isaxito/SolarBatteryCharger/README.md

STM32F103T8 based Battery charger using a 10W solar panel. This is part of my Engineering degree final project.
