isaxito/SolarBatteryCharger/CargadorDeBaterias_rev2/CargadorDeBaterias_rev2.kicad_pcb

## KiCad design CargadorDeBaterias_rev2/CargadorDeBaterias_rev2.kicad_pcb (2025-11-28)

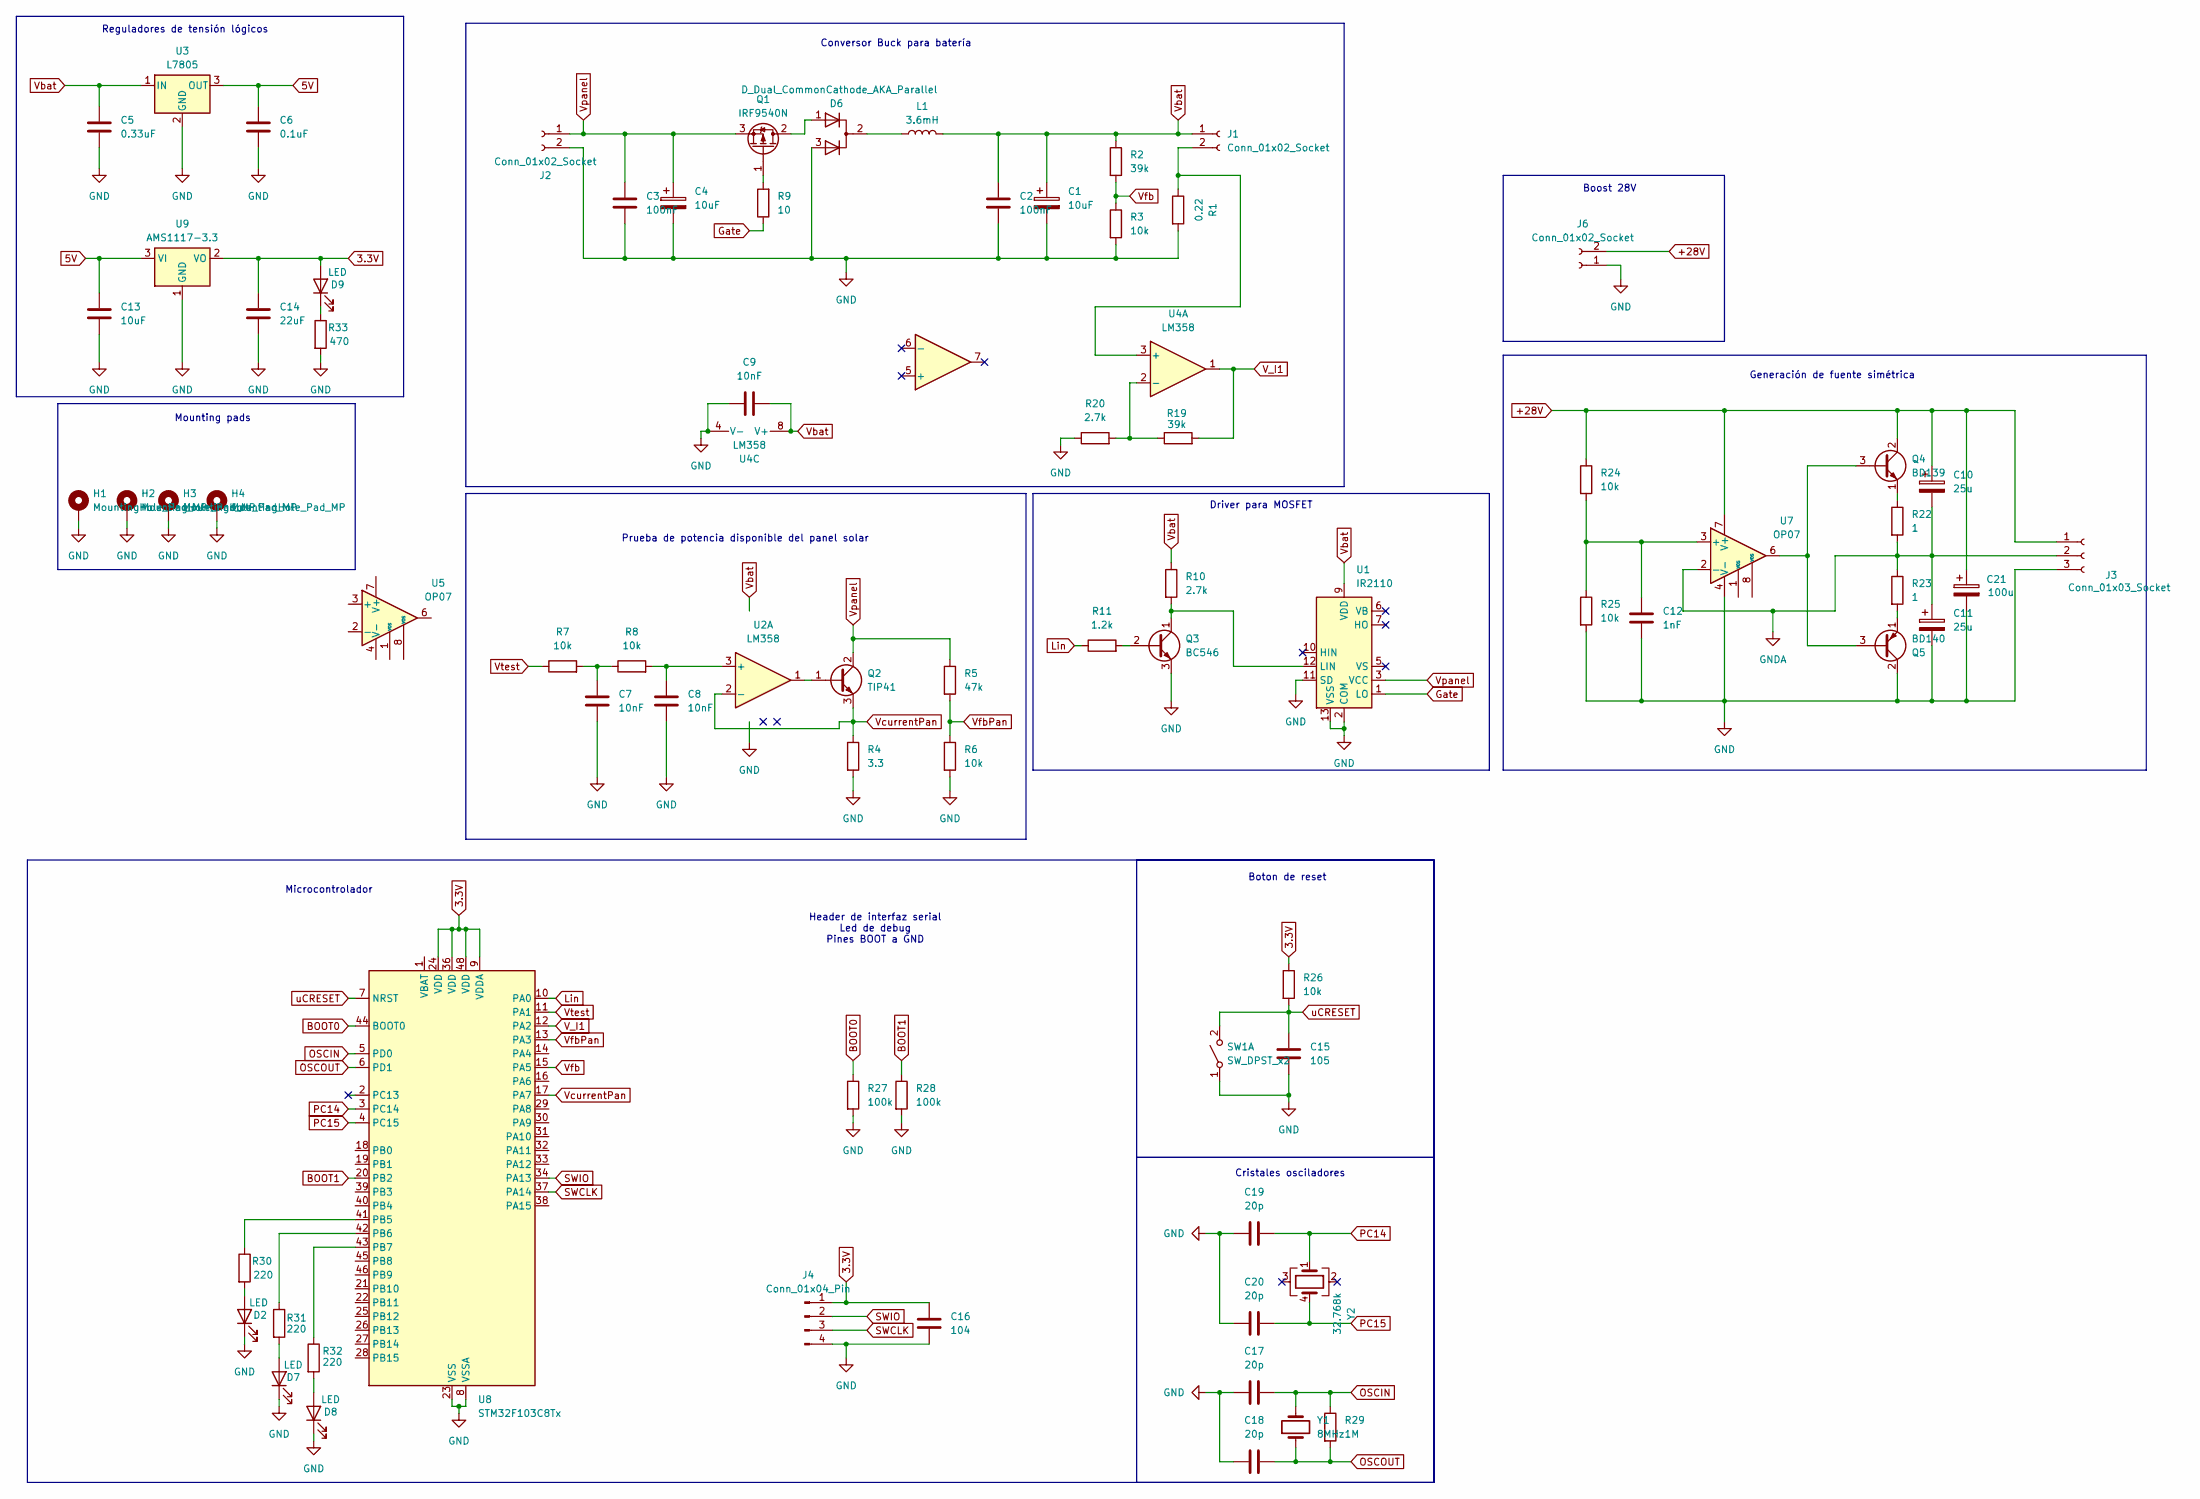
[picture p1: schematic CargadorDeBaterias_rev2.kicad_sch]

Parts:
C1, C4: 10uF; CP_Radial_D5.0mm_P2.50mm
C2, C3: 100nF; C_Disc_D5.0mm_W2.5mm_P5.00mm
C5: 0.33uF; C_Disc_D5.0mm_W2.5mm_P5.00mm
C6: 0.1uF; C_Disc_D5.0mm_W2.5mm_P5.00mm
C7, C8, C9: 10nF; C_Disc_D5.0mm_W2.5mm_P5.00mm
C10, C11: 25u; CP_Radial_D5.0mm_P2.50mm
C12: 1nF; C_Disc_D5.0mm_W2.5mm_P5.00mm
C13: 10uF; C_Disc_D5.0mm_W2.5mm_P5.00mm
C14: 22uF; C_Disc_D5.0mm_W2.5mm_P5.00mm
C15: 105; C_0603_1608Metric_Pad1.08x0.95mm_HandSolder
C16: 104; C_0603_1608Metric_Pad1.08x0.95mm_HandSolder
C17, C18, C19, C20: 20p; C_0603_1608Metric_Pad1.08x0.95mm_HandSolder
C21: 100u; CP_Radial_D6.3mm_P2.50mm
D2, D7, D8, D9: LED; LED_D5.0mm_FlatTop
D6: D_Dual_CommonCathode_AKA_Parallel; TO-220-3_Vertical
H1, H2, H3, H4: MountingHole_Pad_MP; MountingHole_3mm_Pad
J1, J2, J6: Conn_01x02_Socket; TerminalBlock_bornier-2_P5.08mm
J3: Conn_01x03_Socket; TerminalBlock_bornier-3_P5.08mm
J4: Conn_01x04_Pin; PinHeader_1x04_P2.54mm_Horizontal
L1: 3.6mH; L_Radial_D7.5mm_P3.50mm_Fastron_07P
Q1: IRF9540N; TO-220-3_Vertical
Q2: TIP41; TO-220-3_Vertical
Q3: BC546; TO-92_Inline_Wide
Q4: BD139; TO-126-3_Vertical
Q5: BD140; TO-126-3_Vertical
R1: 0.22; R_Axial_DIN0207_L6.3mm_D2.5mm_P10.16mm_Horizontal
R2, R19: 39k; R_Axial_DIN0207_L6.3mm_D2.5mm_P10.16mm_Horizontal
R3, R6, R7, R8, R24, R25, R26: 10k; R_Axial_DIN0207_L6.3mm_D2.5mm_P10.16mm_Horizontal
R4: 3.3; R_Axial_DIN0207_L6.3mm_D2.5mm_P10.16mm_Horizontal
R5: 47k; R_Axial_DIN0207_L6.3mm_D2.5mm_P10.16mm_Horizontal
R9: 10; R_Axial_DIN0207_L6.3mm_D2.5mm_P10.16mm_Horizontal
R10, R20: 2.7k; R_Axial_DIN0207_L6.3mm_D2.5mm_P10.16mm_Horizontal
R11: 1.2k; R_Axial_DIN0207_L6.3mm_D2.5mm_P10.16mm_Horizontal
R22, R23: 1; R_Axial_DIN0207_L6.3mm_D2.5mm_P10.16mm_Horizontal
R27, R28: 100k; R_Axial_DIN0207_L6.3mm_D2.5mm_P10.16mm_Horizontal
R29: 1M; R_Axial_DIN0207_L6.3mm_D2.5mm_P10.16mm_Horizontal
R30, R31, R32: 220; R_Axial_DIN0207_L6.3mm_D2.5mm_P10.16mm_Horizontal
R33: 470; R_Axial_DIN0207_L6.3mm_D2.5mm_P10.16mm_Horizontal
SW1: SW_DPST_x2; SW_SPST_EVQPE1
U1: IR2110; DIP-14_W7.62mm
U2, U4: LM358; DIP-8_W7.62mm
U3: L7805; TO-220-3_Vertical
U5, U7: OP07; DIP-8_W7.62mm
U8: STM32F103C8Tx; LQFP-48_7x7mm_P0.5mm
U9: AMS1117-3.3; SOT-223-3_TabPin2
Y1: 8MHz; Resonator-2Pin_W8.0mm_H3.5mm
Y2: 32.768k; OSCL550P800X320X254-4N

Connections:
3.3V: C14.1, C16.1, D9.2 (A), J4.1, R26.1, U8.9 (VDDA), U8.24 (VDD), U8.36 (VDD), U8.48 (VDD), U9.2 (VO)
5V: C6.1, C13.1, U3.3 (OUT), U9.3 (VI)
+28V: C10.1, C21.1, J3.1, J6.2, Q4.2 (C), R24.1, U7.7 (V+)
BOOT0: R27.1, U8.44 (BOOT0)
BOOT1: R28.1, U8.20 (PB2)
GND: C1.2, C2.2, C3.2, C4.2, C5.2, C6.2, C7.2, C8.2, C9.1, C11.2, C12.2, C13.2, C14.2, C15.2, C16.2, C17.1, C18.1, C19.1, C20.1, C21.2, D2.1 (K), D6.3 (A), D7.1 (K), D8.1 (K), H1.MP, H2.MP, H3.MP, H4.MP, J2.2, J3.3, J4.4, J6.1, Q3.3 (E), Q5.2 (C), R1.2, R3.2, R4.2, R6.2, R20.1, R25.2, R27.2, R28.2, R33.2, SW1.1 (A), U1.2 (COM), U1.11 (SD), U1.13 (VSS), U3.2 (GND), U4.4 (V-), U5.4 (V-), U7.4 (V-), U8.8 (VSSA), U8.23 (VSS), U8.35 (VSS), U8.47 (VSS), U9.1 (GND)
GNDA: C10.2, C11.1, J3.2, R22.2, R23.1, U7.2 (-)
Gate: R9.1, U1.1 (LO)
Lin: R11.1, U8.10 (PA0)
unnamed: C7.1, R7.2, R8.1
unnamed: D2.2 (A), R30.2
unnamed: D6.2 (K), L1.1
unnamed: D7.2 (A), R31.2
unnamed: D8.2 (A), R32.2
unnamed: D9.1 (K), R33.1
unnamed: J1.2, R1.1, U4.3 (+)
unnamed: D6.1 (A), Q1.2 (D)
unnamed: Q1.1 (G), R9.2
unnamed: Q2.1 (B), U2.1, U5.6
unnamed: Q3.2 (B), R11.2
unnamed: Q3.1 (C), R10.2, U1.12 (LIN)
unnamed: Q4.3 (B), Q5.3 (B), U7.6
unnamed: Q4.1 (E), R22.1
unnamed: Q5.1 (E), R23.2
unnamed: R19.1, R20.2, U4.2 (-)
unnamed: C12.1, R24.2, R25.1, U7.3 (+)
unnamed: R30.1, U8.41 (PB5)
unnamed: R31.1, U8.42 (PB6)
unnamed: R32.1, U8.43 (PB7)
OSCIN: C17.2, R29.1, U8.5 (PD0), Y1.2
OSCOUT: C18.2, R29.2, U8.6 (PD1), Y1.1
PC14: C19.2, U8.3 (PC14), Y2.1
PC15: C20.2, U8.4 (PC15), Y2.4
SWCLK: J4.3, U8.37 (PA14)
SWIO: J4.2, U8.34 (PA13)
V_I1: R19.2, U4.1, U8.12 (PA2)
Vbat: C1.1, C2.1, C5.1, C9.2, J1.1, L1.2, R2.1, R10.1, U1.9 (VDD), U3.1 (IN), U4.8 (V+), U5.7 (V+)
VcurrentPan: Q2.3 (E), R4.1, U2.2 (-), U5.2 (-), U8.17 (PA7)
Vfb: R2.2, R3.1, U8.15 (PA5)
VfbPan: R5.2, R6.1, U8.13 (PA3)
Vpanel: C3.1, C4.1, J2.1, Q1.3 (S), Q2.2 (C), R5.1, U1.3 (VCC)
Vtest: R7.1, U8.11 (PA1)
uCRESET: C15.1, R26.2, SW1.2 (B), U8.7 (NRST)

Notes on the sheet:
Microcontrolador
Header de interfaz serial Led de debug Pines BOOT a GND
Boton de reset
Cristales osciladores
Conversor Buck para batería
Mounting pads
Driver para MOSFET
Boost 28V
Generación de fuente simétrica
Prueba de potencia disponible del panel solar
Reguladores de tensión lógicos

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
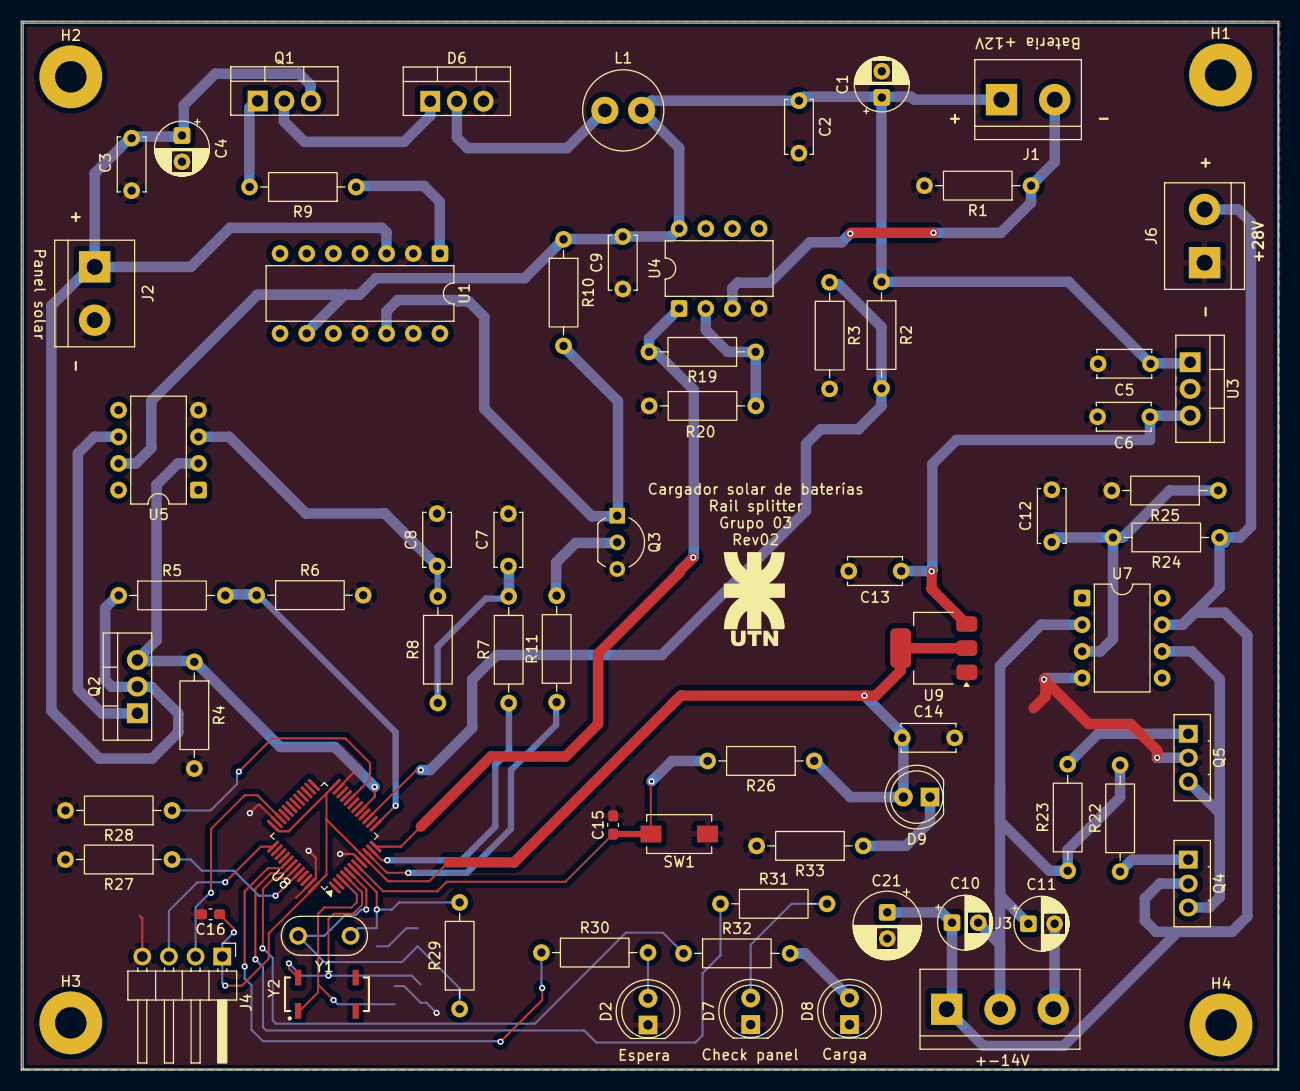
[picture p2: board CargadorDeBaterias_rev2.kicad_pcb from above]

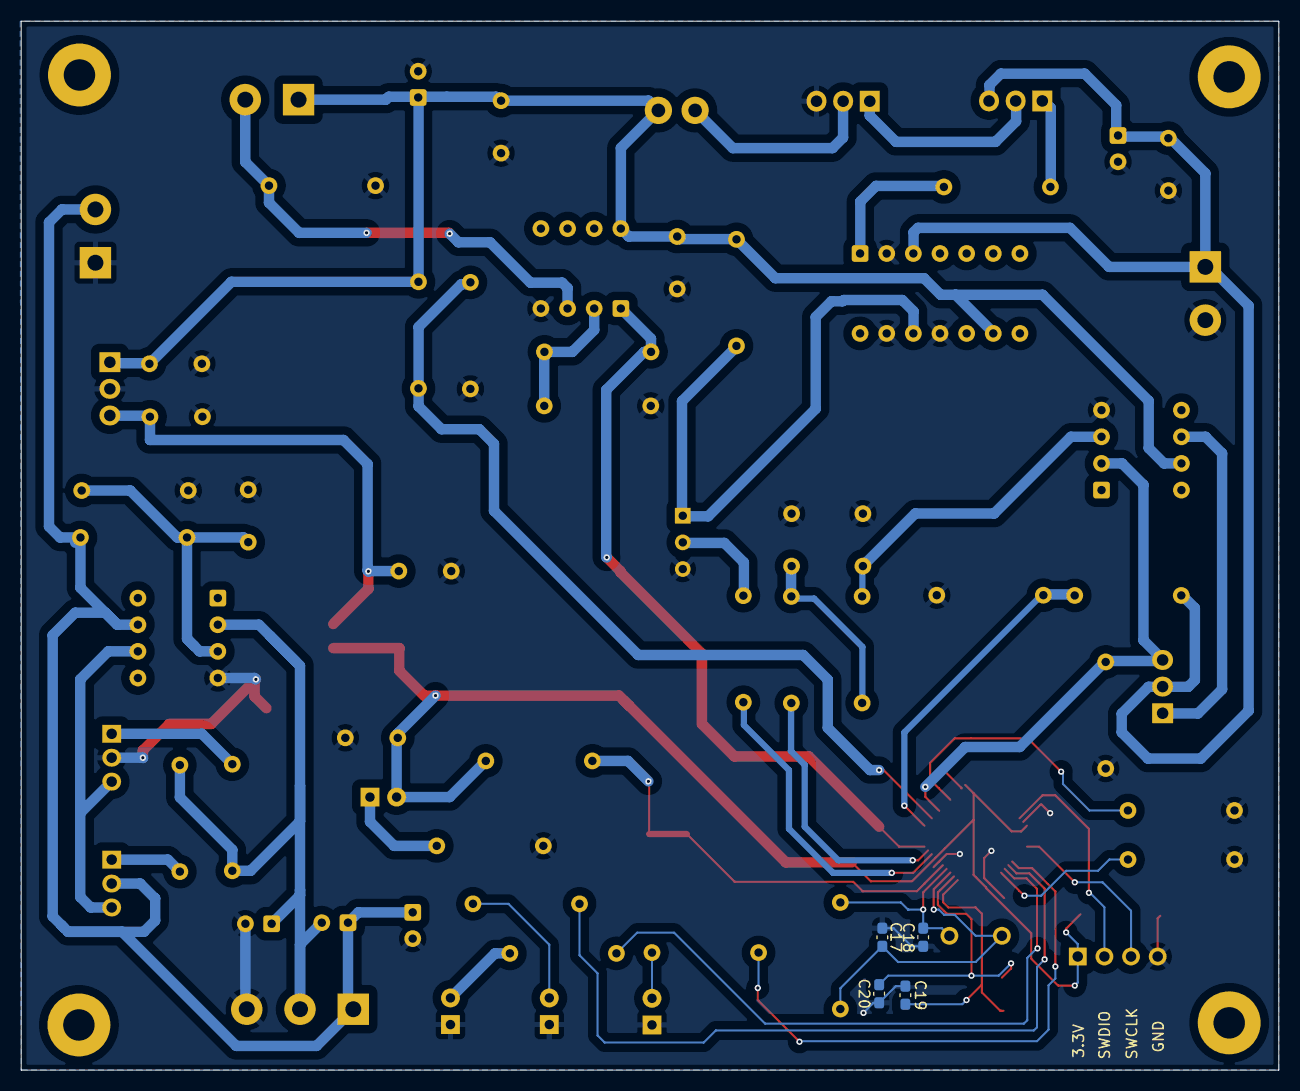
[picture p3: board CargadorDeBaterias_rev2.kicad_pcb from below]

Board: 2 copper layers, 119.9 x 100.0 mm, 76 parts (4 on the bottom side), 44 nets.
