isaxito/SolarBatteryCharger/Core/Src/main.c

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
/* Includes ------------------------------------------------------------------*/
#include "main.h"

/* USER CODE BEGIN Includes */
#define I_MAX 0.4
#define V_MAX 13.6//14.3
#define VOLT_READINGS 40
#define CURRENT_READINGS 40
#define ADC_READINGS 4
#define R2 39.0 // kOhm
#define R3 10.0 // kOhm
#define R5 47.0 // kOhm
#define R6 10.0 // kOhm
//#define R17 47.0 // kOhm
//#define R12 2.7 // kOhm
#define R19 39 // kOhm
#define R20 2.7 // kOhm
#define R_PANEL_SHUNT 3.3 // Ohm
#define R_SHUNT 0.22 // Ohm
#define Vref 3.25 // Hardcode horrible para probar

#define ADC0CAL 0
#define ADC1CAL 0
#define ADC2CAL 550
#define ADC3CAL 0


/* USER CODE END Includes */

ADC_HandleTypeDef hadc1;

TIM_HandleTypeDef htim2;
TIM_HandleTypeDef htim4;

void SystemClock_Config(void);
static void MX_GPIO_Init(void);
static void MX_TIM2_Init(void);
static void MX_ADC1_Init(void);
static void MX_TIM4_Init(void);
/* USER CODE BEGIN 0 */

uint16_t duty1 = 50;  // CH1 (PA0)
uint16_t duty2 = 35;  // CH2 (PA1)
uint16_t duty1_ccr = 720;
uint16_t duty2_ccr = 720;
uint16_t power_on_flag = 1;
float adc_readings[ADC_READINGS];
float voltage_panel[VOLT_READINGS];
float volt_panel_avg=0.0;
float voltage_battery[VOLT_READINGS];
float volt_batt_avg=0.0;
float test_shunt_panel[CURRENT_READINGS];
float current_panel_avg=0.0;
float volt1_shunt[CURRENT_READINGS];
float volt1_avg=0.0;
float load_current=0.0;


uint16_t tim4_counterr = 0; // Each count is 40s, up to the desired check value in standby mode.

/* State machine states:
	0: Standby
	1: Sunlight check
	2: Charge battery
*/
uint16_t sm_state = 0;

void SetDutyCycle(TIM_HandleTypeDef *htim, uint32_t Channel, uint32_t DutyPercent)
{
  uint32_t arr = htim->Init.Period + 1;
  uint32_t ccr = (DutyPercent * arr) / 100;
  __HAL_TIM_SET_COMPARE(htim, Channel, ccr);
}

void readADC_inputs()
{
	for(int i=0; i<ADC_READINGS; i++)
	{
		HAL_ADC_Start(&hadc1); // Start ADC Conversion
		HAL_ADC_PollForConversion(&hadc1, 1); // Poll ADC1 Peripheral & TimeOut = 1mSec
		adc_readings[i] = HAL_ADC_GetValue(&hadc1); // Read ADC Conversion Result
		HAL_Delay(1);
	}
}

void sunlightCheck()
{
	// Activate solar panel test with current source (view schematic)
	SetDutyCycle(&htim2, TIM_CHANNEL_2, duty2);
	// Wait 500ms
	HAL_Delay(500);
	// Read panel voltage divider and test current values
	for(int i=0; i < VOLT_READINGS; i++)
	{
		readADC_inputs();
		voltage_panel[i] = adc_readings[0];
		test_shunt_panel[i] = adc_readings[1];
		voltage_battery[i] = adc_readings[2];
		HAL_Delay(1);
	}

	// Deactivate solar panel test with current source
	SetDutyCycle(&htim2, TIM_CHANNEL_2, 0);

	// Average readings
	volt_panel_avg = 0;
	current_panel_avg = 0;
	volt_batt_avg = 0;
	for(int i=0; i < VOLT_READINGS; i++)
	{
		volt_panel_avg += voltage_panel[i] + ADC1CAL;
		current_panel_avg += test_shunt_panel[i] + ADC0CAL;
		volt_batt_avg += voltage_battery[i] + ADC2CAL;
	}
	// Calculate real average panel voltage and test current
	volt_panel_avg = ( ((volt_panel_avg / VOLT_READINGS)*Vref)/4095.0 ) * ((R5+R6)/R6) ;
	current_panel_avg = ( ((current_panel_avg / VOLT_READINGS)*Vref)/4095.0 ) / R_PANEL_SHUNT;
	volt_batt_avg = ( ((volt_panel_avg / VOLT_READINGS)*Vref)/4095.0 ) * ((R2+R3)/R3);
}

void testADC()
{
   // Read shunt terminal voltages
   for(int i=0; i < VOLT_READINGS; i++)
	{
		readADC_inputs();
		voltage_panel[i] = adc_readings[0];
		test_shunt_panel[i] = adc_readings[1];
		voltage_battery[i] = adc_readings[2];
		volt1_shunt[i] = adc_readings[3];
	}
   // Average readings
   volt_panel_avg = 0;
   current_panel_avg = 0;
   volt_batt_avg = 0;
   volt1_avg = 0;
   for(int i=0; i < VOLT_READINGS; i++)
   {
	   volt_panel_avg += voltage_panel[i];
	   current_panel_avg += test_shunt_panel[i];
	   volt_batt_avg += voltage_battery[i];
	   volt1_avg += volt1_shunt[i];
   }

   // Finish calculating average and real voltages

   volt_panel_avg = ( ((volt_panel_avg / VOLT_READINGS)*Vref)/4095.0 ) * ((R5+R6)/R6) ;
   current_panel_avg = current_panel_avg / VOLT_READINGS;
   load_current = (( (( (volt1_avg / VOLT_READINGS)*Vref)/4095.0) / (1 + R19/R20) )) / R_SHUNT ; // Current load
   volt_batt_avg = ( ((volt_batt_avg / VOLT_READINGS)*Vref)/4095.0 ) * ((R2+R3)/R3); // Battery voltage
}

void adjustChargerPWM()
{
   // Read shunt terminal voltages
   for(int i=0; i < VOLT_READINGS; i++)
	{
		readADC_inputs();
		voltage_panel[i] = adc_readings[0];
		voltage_battery[i] = adc_readings[2];
		volt1_shunt[i] = adc_readings[3];
	}
   // Average readings
   volt_panel_avg = 0;
   volt_batt_avg = 0;
   volt1_avg = 0;
   for(int i=0; i < VOLT_READINGS; i++)
   {
	   volt_panel_avg += voltage_panel[i] + ADC1CAL;
	   volt_batt_avg += voltage_battery[i] + ADC2CAL;
	   volt1_avg += volt1_shunt[i] + ADC0CAL;
   }

   // Finish calculating average and real voltages

   volt_panel_avg = ( ((volt_panel_avg / VOLT_READINGS)*Vref)/4095.0 ) * ((R5+R6)/R6) ;
   volt_batt_avg = ( ((volt_batt_avg / VOLT_READINGS)*Vref)/4095.0 ) * ((R2+R3)/R3); // Battery voltage
   load_current = (( (( (volt1_avg / VOLT_READINGS)*Vref)/4095.0) / (1 + R19/R20) )) / R_SHUNT ; // Current load

   // PWM Duty control logic for constant current and voltage modes

   if(load_current < I_MAX){
	  if(volt_batt_avg < V_MAX){
		 if(duty1<92)
			 duty1++;
		 HAL_Delay(2);
		 SetDutyCycle(&htim2, TIM_CHANNEL_1, duty1);
	  }
	  else{
		 if(duty1>6)
			 duty1--;
		 HAL_Delay(2);
		 SetDutyCycle(&htim2, TIM_CHANNEL_1, duty1);
	  }
   }
   else
   {
	   HAL_GPIO_WritePin(GPIOC, GPIO_PIN_13, GPIO_PIN_SET);
	   HAL_Delay(100);
	   HAL_GPIO_WritePin(GPIOC, GPIO_PIN_13, GPIO_PIN_RESET);
	   HAL_Delay(100);
   }

//   if(load_current < I_MAX){
//	  if(volt_batt_avg < V_MAX){
//		 if(duty1_ccr<1430)
//			 duty1_ccr++;
//		 HAL_Delay(1);
//		 __HAL_TIM_SET_COMPARE(&htim2, TIM_CHANNEL_1, duty1_ccr);
//	  }
//	  else{
//		 if(duty1_ccr>4)
//			duty1_ccr--;
//		 HAL_Delay(1);
//		 __HAL_TIM_SET_COMPARE(&htim2, TIM_CHANNEL_1, duty1_ccr);
//	  }
//   }
}

void updateStateLed(int state_num)
{
	switch(state_num)
	{
	case 0:
		HAL_GPIO_WritePin(GPIOB, GPIO_PIN_5, GPIO_PIN_SET);
		HAL_GPIO_WritePin(GPIOB, GPIO_PIN_6, GPIO_PIN_RESET);
		HAL_GPIO_WritePin(GPIOB, GPIO_PIN_7, GPIO_PIN_RESET);

		break;
	case 1:
		HAL_GPIO_WritePin(GPIOB, GPIO_PIN_5, GPIO_PIN_RESET);
		HAL_GPIO_WritePin(GPIOB, GPIO_PIN_6, GPIO_PIN_SET);
		HAL_GPIO_WritePin(GPIOB, GPIO_PIN_7, GPIO_PIN_RESET);
		break;
	case 2:
		HAL_GPIO_WritePin(GPIOB, GPIO_PIN_5, GPIO_PIN_RESET);
		HAL_GPIO_WritePin(GPIOB, GPIO_PIN_6, GPIO_PIN_RESET);
		HAL_GPIO_WritePin(GPIOB, GPIO_PIN_7, GPIO_PIN_SET);
		break;
	default:
		break;

	}
}

void HAL_TIM_PeriodElapsedCallback(TIM_HandleTypeDef* htim)
{
	// When turned on, uC comes here directly without waiting for the timer, so this is a fix for the moment

	if(power_on_flag)
		tim4_counterr = 0;
	else
		tim4_counterr++;

	if(tim4_counterr==1)
	{
		// Check sunlight flag every 80 seconds (for example)
		if(sm_state == 0)
		{
			sm_state = 1;
			HAL_GPIO_WritePin(GPIOC, GPIO_PIN_13, GPIO_PIN_SET);
			//HAL_Delay(1000);
		}
		tim4_counterr = 0;
	}
}

/* USER CODE END 0 */

/**
  * @brief  The application entry point.
  * @retval int
  */
int main(void)
{

  /* USER CODE BEGIN 1 */

	//uint16_t adc_reading = 0;

  /* USER CODE END 1 */

  /* MCU Configuration--------------------------------------------------------*/

  /* Reset of all peripherals, Initializes the Flash interface and the Systick. */
  HAL_Init();

  /* Configure the system clock */
  SystemClock_Config();

  /* Initialize all configured peripherals */
  MX_GPIO_Init();
  MX_TIM2_Init();
  MX_ADC1_Init();
  MX_TIM4_Init();
  /* USER CODE BEGIN 2 */

  HAL_TIM_Base_Start_IT(&htim4);
  HAL_TIM_PWM_Start(&htim2, TIM_CHANNEL_1);
  HAL_TIM_PWM_Start(&htim2, TIM_CHANNEL_2);
  SetDutyCycle(&htim2, TIM_CHANNEL_1, 5);
  SetDutyCycle(&htim2, TIM_CHANNEL_2, 0);

  HAL_GPIO_WritePin(GPIOB, GPIO_PIN_5|GPIO_PIN_6|GPIO_PIN_7, GPIO_PIN_RESET);

  HAL_GPIO_WritePin(GPIOC, GPIO_PIN_13, GPIO_PIN_RESET);
  HAL_Delay(500);
  HAL_GPIO_WritePin(GPIOC, GPIO_PIN_13, GPIO_PIN_SET);
  HAL_Delay(500);
  HAL_GPIO_WritePin(GPIOC, GPIO_PIN_13, GPIO_PIN_RESET);
  HAL_Delay(500);
  HAL_GPIO_WritePin(GPIOC, GPIO_PIN_13, GPIO_PIN_SET);
  HAL_Delay(500);
  HAL_GPIO_WritePin(GPIOC, GPIO_PIN_13, GPIO_PIN_RESET);
  HAL_Delay(500);
  HAL_GPIO_WritePin(GPIOC, GPIO_PIN_13, GPIO_PIN_SET);
  HAL_Delay(500);
  HAL_GPIO_WritePin(GPIOC, GPIO_PIN_13, GPIO_PIN_RESET);

  power_on_flag = 1;

  /* USER CODE END 2 */

  /* Infinite loop */
  /* USER CODE BEGIN WHILE */
  //while(1)
  //	  testADC();

  while (1)
  {

	switch(sm_state)
	{
	case 0: // Standby, timer will periodically change sm_state to 1.
		power_on_flag = 0;
		// Stay, do nothing but maintain PWM outputs OFF
		SetDutyCycle(&htim2, TIM_CHANNEL_1, 5);
		SetDutyCycle(&htim2, TIM_CHANNEL_2, 0);
		// Update indicator LEDs
		updateStateLed(sm_state);

		break;
	case 1: // Sunlight check
		// Update indicator LEDs
		HAL_GPIO_WritePin(GPIOC, GPIO_PIN_13, GPIO_PIN_RESET);
		updateStateLed(sm_state);

		sunlightCheck();

		if((volt_panel_avg >= 12.0) && (current_panel_avg >= 0.25) && volt_batt_avg < 14.3) // volt_panel_avg >= 10.0
		{
			sm_state = 2; // Go to charge battery state
			SetDutyCycle(&htim2, TIM_CHANNEL_1, 50);
			SetDutyCycle(&htim2, TIM_CHANNEL_2, 0);
		}else
			sm_state = 2;//0; bypass check for test // Go back to standby state
		break;

	case 2: // Charge battery
		// Update indicator LEDs
		updateStateLed(sm_state);
		// Charging algorithm and reading of ADCs
		adjustChargerPWM();

		if(volt_batt_avg >= 15.0 || volt_panel_avg < 12.0) // volt_panel_avg < 5.0
		{
			// Turns OFF Charger and goes to standby
			SetDutyCycle(&htim2, TIM_CHANNEL_1, 5);
			sm_state = 0;
		}
		else
			sm_state = 2;
		break;

	default:
		sm_state = 0;
		SetDutyCycle(&htim2, TIM_CHANNEL_1, 5);
		SetDutyCycle(&htim2, TIM_CHANNEL_2, 0);
		break;
	}


    /* USER CODE END WHILE */

    /* USER CODE BEGIN 3 */
  }
  /* USER CODE END 3 */
}

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
