isaxito/SolarBatteryCharger/(commit log)

2025-08-14 Last advances. At this point, the charger is working with major modifications in the circuit.
2025-11-28 Upload last changes for final circuit
2025-11-28 Upload kicad files
    [CargadorDeBaterias_rev2-B_Cu.gbr, CargadorDeBaterias_rev2-B_Mask.gbr, CargadorDeBaterias_rev2-B_Paste.gbr, CargadorDeBaterias_rev2-B_Silkscreen.gbr, CargadorDeBaterias_rev2-Edge_Cuts.gbr, CargadorDeBaterias_rev2-F_Cu.gbr, CargadorDeBaterias_rev2-F_Mask.gbr, CargadorDeBaterias_rev2-F_Paste.gbr]
2025-12-12 Upload last changes. Increase charge current, correct R19. Change panel voltage limits
    [main.c]
2026-01-29 Lower maximum battery voltage control
